skhansazoo/brick-pcbs/Brick05-VoltageSource03/ADP7118-regulator.kicad_sch

## KiCad design Brick05-VoltageSource03/ADP7118-regulator.kicad_sch (2025-06-24)

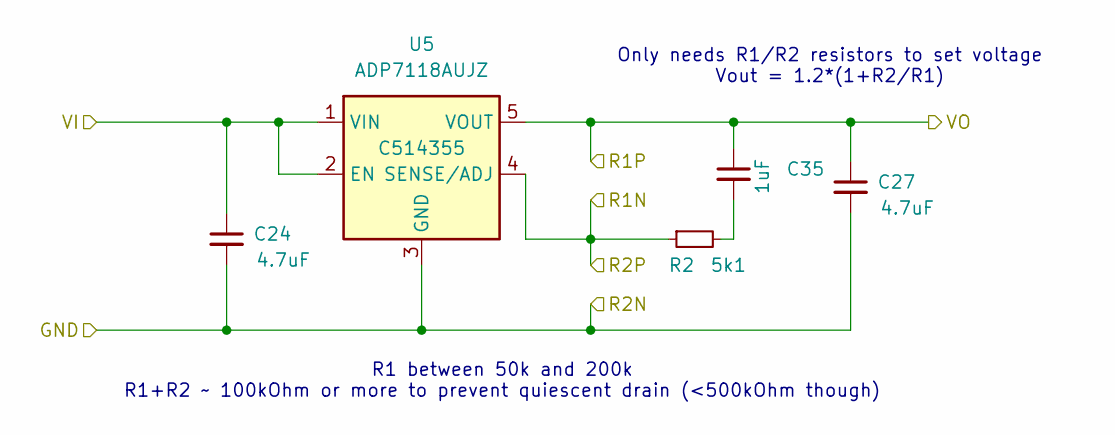
[picture p1: schematic ADP7118-regulator.kicad_sch]

Parts:
C24, C27: 4.7uF; C_0805_2012Metric; LCSC C1779
C35: 1uF; C_0603_1608Metric; LCSC C15849
R2: 5k1; R_0402_1005Metric; LCSC C25905
U5: ADP7118AUJZ; TSOT-23-5; LCSC C514355

Connections:
GND: C24.2, C27.2, U5.3 (GND)
unnamed: C35.2, R2.2
R1N: R2.1, U5.4 (SENSE/ADJ)
R1P: C27.1, C35.1, U5.5 (VOUT)
VI: C24.1, U5.1 (VIN), U5.2 (EN)

Notes on the sheet:
R1 between 50k and 200k R1+R2 ~ 100kOhm or more to prevent quiescent drain (<500kOhm though)
Only needs R1/R2 resistors to set voltage Vout = 1.2*(1+R2/R1)
