skhansazoo/brick-pcbs/Brick05-VoltageSource03/Brick05-VoltageSource03.kicad_sch

## KiCad design Brick05-VoltageSource03/Brick05-VoltageSource03.kicad_sch (2025-06-24)

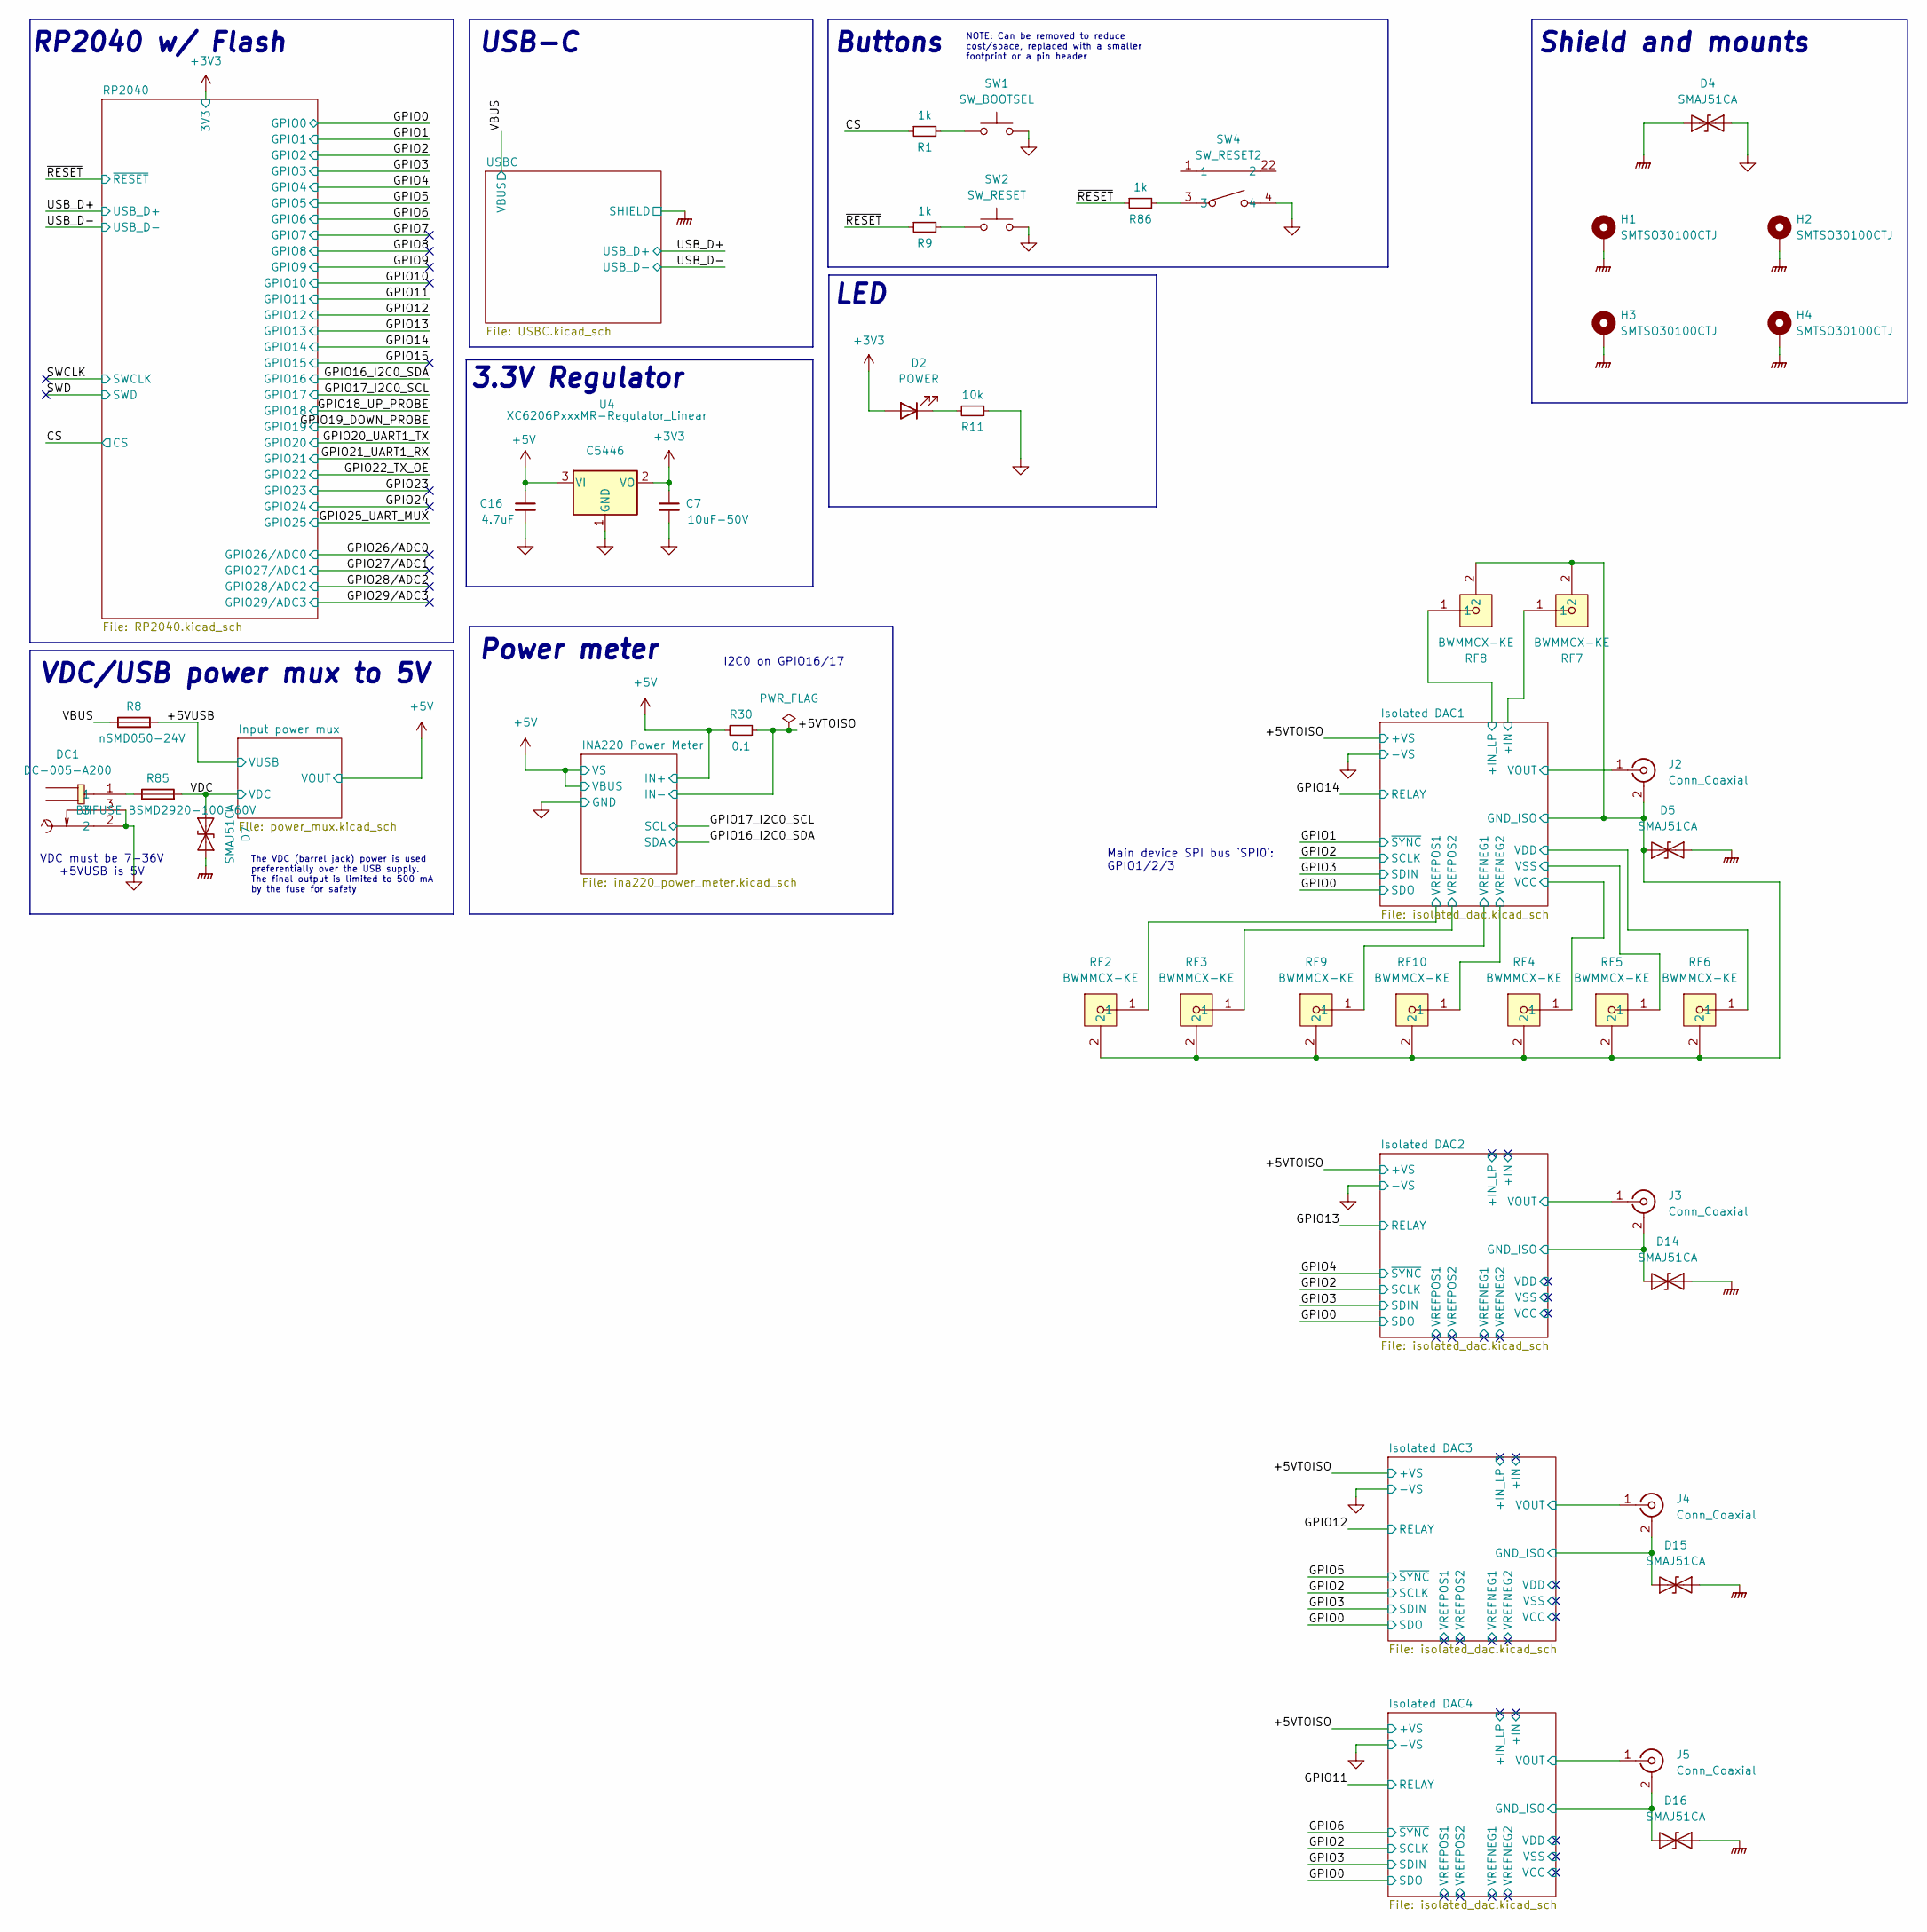
[picture p2: schematic Brick05-VoltageSource03.kicad_sch]

Parts:
C7: 10uF-50V; C_0805_2012Metric; LCSC C440198
C16: 4.7uF; C_0805_2012Metric; LCSC C1779
D2: POWER; LED_0805_2012Metric; LCSC C2297
D4, D5, D7, D14, D15, D16: SMAJ51CA; D_SMA; LCSC C148234
DC1: DC-005-A200; DC-IN-TH_DC-005-A200; LCSC Part C720557
H1, H2, H3, H4: SMTSO30100CTJ; SMD_BD5.6-L5.6-W5.6-D4.1; LCSC C2916370
J2, J3, J4, J5: Conn_Coaxial; BNC_Amphenol_B6252HB-NPP3G-50_Horizontal; LCSC C2837587
R1, R9, R86: 1k; R_0402_1005Metric; LCSC C11702
R8: nSMD050-24V; R_1206_3216Metric; LCSC C369160
R11: 10k; R_0402_1005Metric; LCSC C25744
R30: 0.1; R_1206_3216Metric; LCSC C25334
R85: BHFUSE BSMD2920-100-60V; Fuse_2920_7451Metric; LCSC C3020148
RF2, RF3, RF4, RF5, RF6, RF7, RF8, RF9, RF10: BWMMCX-KE; MMCX_Molex_73415-1471_Vertical; LCSC Part C5137198
SW1: SW_BOOTSEL; SW-SMD_L3.9-W3.0-P4.45; LCSC C720477
SW2: SW_RESET; SW-SMD_L3.9-W3.0-P4.45; LCSC C720477
SW4: SW_RESET2; SW-SMD_TS24CA; LCSC Part C393942
U4: XC6206PxxxMR-Regulator_Linear; SOT-23-3; LCSC C5446

Connections:
+3V3: C7.1, D2.2 (A), U4.2 (VO)
+5V: C16.1, R30.2, U4.3 (VI)
+5VTOISO: R30.1
+5VUSB: R8.2
+IN: RF7.1
+IN_LP: RF8.1
CS: R1.1
GND: C7.2, C16.2, D4.2 (A2), DC1.2, DC1.3, R11.2, SW1.1, SW2.1, SW4.4, U4.1 (GND)
GND_ISO: D5.1 (A1), D14.1 (A1), D15.1 (A1), D16.1 (A1), J2.2 (Ext), J3.2 (Ext), J4.2 (Ext), J5.2 (Ext), RF2.2, RF3.2, RF4.2, RF5.2, RF6.2, RF7.2, RF8.2, RF9.2, RF10.2
unnamed: D2.1 (K), R11.1
unnamed: DC1.1, R85.1
unnamed: R1.2, SW1.2
unnamed: R9.2, SW2.2
unnamed: R86.2, SW4.3
SHIELD: D4.1 (A1), D5.2 (A2), D7.2 (A2), D14.2 (A2), D15.2 (A2), D16.2 (A2), H1.1, H2.1, H3.1, H4.1
VBUS: R8.1
VCC: RF4.1
VDC: D7.1 (A1), R85.2
VDD: RF6.1
VOUT: J2.1 (In), J3.1 (In), J4.1 (In), J5.1 (In)
VREFNEG1: RF9.1
VREFNEG2: RF10.1
VREFPOS1: RF2.1
VREFPOS2: RF3.1
VSS: RF5.1
~RESET: R9.1, R86.1

Notes on the sheet:
RP2040 w/ Flash
3.3V Regulator
Shield and mounts
LED
VDC/USB power mux to 5V
USB-C
VDC must be 7-36V +5VUSB is 5V
Buttons
Power meter
The VDC (barrel jack) power is used preferentially over the USB supply. The final output is limited to 500 mA by the fuse for safety
Main device SPI bus `SPI0`: GPIO1/2/3
I2C0 on GPIO16/17
NOTE: Can be removed to reduce cost/space, replaced with a smaller footprint or a pin header
