skhansazoo/brick-pcbs/Brick05-VoltageSource03/RP2040.kicad_sch

## KiCad design Brick05-VoltageSource03/RP2040.kicad_sch (2025-06-24)

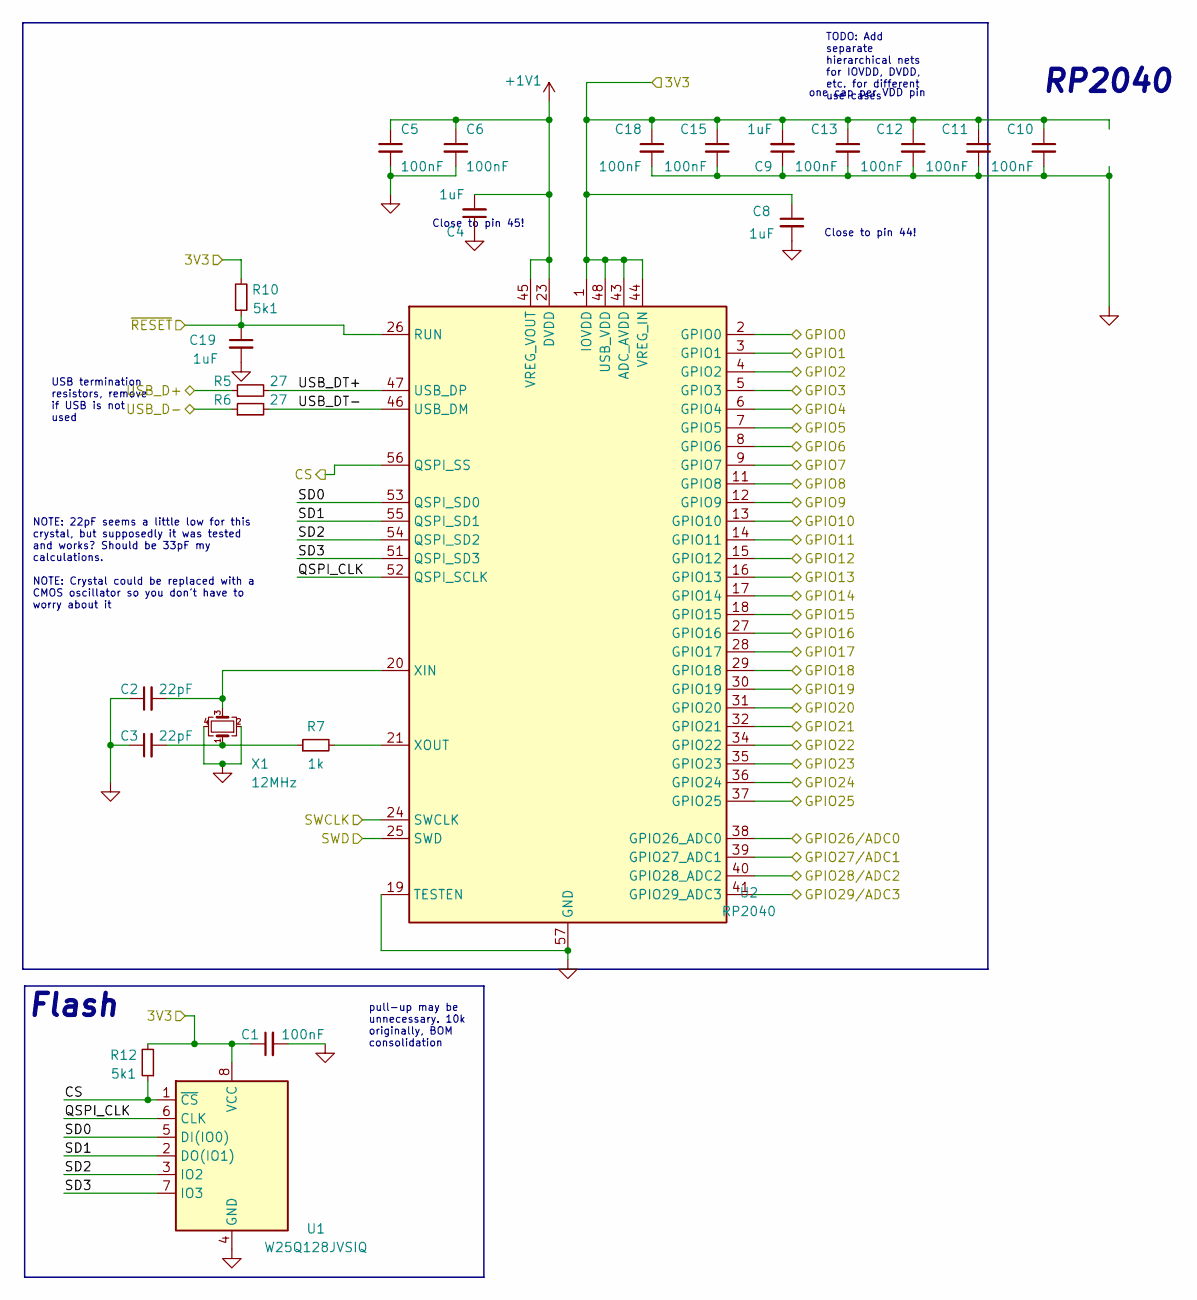
[picture p3: schematic RP2040.kicad_sch]

Parts:
C1, C5, C6, C10, C11, C12, C13, C15, C18: 100nF; C_0402_1005Metric; LCSC C1525
C2, C3: 22pF; C_0402_1005Metric; LCSC C1555
C4, C8, C9, C19: 1uF; C_0402_1005Metric; LCSC C52923
R5, R6: 27; R_0402_1005Metric; LCSC C138021
R7: 1k; R_0402_1005Metric; LCSC C11702
R10, R12: 5k1; R_0402_1005Metric; LCSC C25905
U1: W25Q128JVSIQ; SOIC-8_5.23x5.23mm_P1.27mm; LCSC C97521
U2: RP2040; QFN-56-1EP_7x7mm_P0.4mm_EP3.2x3.2mm; LCSC C2040
X1: 12MHz; Crystal_SMD_3225-4Pin_3.2x2.5mm; LCSC C9002

Connections:
3V3: C1.1, C8.1, C9.2, C10.1, C11.1, C12.1, C13.1, C15.1, C18.1, R10.2, R12.2, U1.8 (VCC), U2.1 (IOVDD), U2.10 (IOVDD), U2.22 (IOVDD), U2.33 (IOVDD), U2.42 (IOVDD), U2.43 (ADC_AVDD), U2.44 (VREG_IN), U2.48 (USB_VDD), U2.49 (IOVDD)
+1V1: C4.2, C5.1, C6.1, U2.23 (DVDD), U2.45 (VREG_VOUT), U2.50 (DVDD)
CS: R12.1, U1.1 (~CS), U2.56 (QSPI_SS)
GND: C1.2, C2.1, C3.1, C4.1, C5.2, C6.2, C8.2, C9.1, C10.2, C11.2, C12.2, C13.2, C15.2, C18.2, C19.2, U1.4 (GND), U2.19 (TESTEN), U2.57 (GND), X1.2, X1.4
GPIO0: U2.2 (GPIO0)
GPIO1: U2.3 (GPIO1)
GPIO2: U2.4 (GPIO2)
GPIO3: U2.5 (GPIO3)
GPIO4: U2.6 (GPIO4)
GPIO5: U2.7 (GPIO5)
GPIO6: U2.8 (GPIO6)
GPIO7: U2.9 (GPIO7)
GPIO8: U2.11 (GPIO8)
GPIO9: U2.12 (GPIO9)
GPIO10: U2.13 (GPIO10)
GPIO11: U2.14 (GPIO11)
GPIO12: U2.15 (GPIO12)
GPIO13: U2.16 (GPIO13)
GPIO14: U2.17 (GPIO14)
GPIO15: U2.18 (GPIO15)
GPIO16: U2.27 (GPIO16)
GPIO17: U2.28 (GPIO17)
GPIO18: U2.29 (GPIO18)
GPIO19: U2.30 (GPIO19)
GPIO20: U2.31 (GPIO20)
GPIO21: U2.32 (GPIO21)
GPIO22: U2.34 (GPIO22)
GPIO23: U2.35 (GPIO23)
GPIO24: U2.36 (GPIO24)
GPIO25: U2.37 (GPIO25)
GPIO26/ADC0: U2.38 (GPIO26_ADC0)
GPIO27/ADC1: U2.39 (GPIO27_ADC1)
GPIO28/ADC2: U2.40 (GPIO28_ADC2)
GPIO29/ADC3: U2.41 (GPIO29_ADC3)
unnamed: C2.2, U2.20 (XIN), X1.3
unnamed: C3.2, R7.1, X1.1
unnamed: R7.2, U2.21 (XOUT)
QSPI_CLK: U1.6 (CLK), U2.52 (QSPI_SCLK)
SD0: U1.5 (DI(IO0)), U2.53 (QSPI_SD0)
SD1: U1.2 (DO(IO1)), U2.55 (QSPI_SD1)
SD2: U1.3 (IO2), U2.54 (QSPI_SD2)
SD3: U1.7 (IO3), U2.51 (QSPI_SD3)
SWCLK: U2.24 (SWCLK)
SWD: U2.25 (SWD)
USB_D+: R5.1
USB_D-: R6.1
USB_DT+: R5.2, U2.47 (USB_DP)
USB_DT-: R6.2, U2.46 (USB_DM)
~RESET: C19.1, R10.1, U2.26 (RUN)

Notes on the sheet:
RP2040
Flash
USB termination resistors, remove if USB is not used
Close to pin 45!
one cap per VDD pin
NOTE: 22pF seems a little low for this crystal, but supposedly it was tested and works? Should be 33pF my calculations. NOTE: Crystal could be replaced with a CMOS oscillator so you don't have to worry about it
TODO: Add separate hierarchical nets for IOVDD, DVDD, etc. for different use cases
pull-up may be unnecessary. 10k originally, BOM consolidation
Close to pin 44!
