skhansazoo/brick-pcbs/Brick05-VoltageSource03/USBC.kicad_sch

## KiCad design Brick05-VoltageSource03/USBC.kicad_sch (2025-06-24)

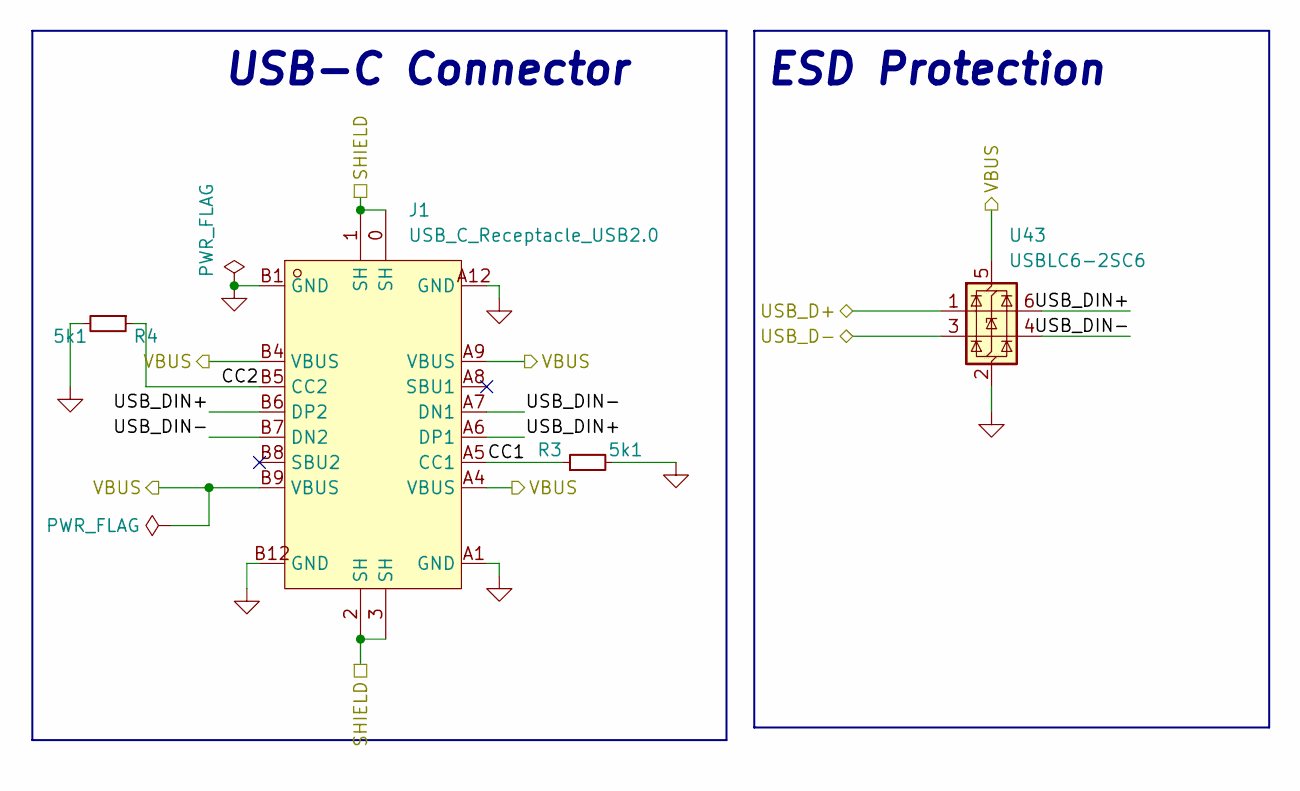
[picture p4: schematic USBC.kicad_sch]

Parts:
J1: USB_C_Receptacle_USB2.0; USB-C_SMD-TYPE-C-31-M-12; LCSC C165948
R3, R4: 5k1; R_0402_1005Metric; LCSC C25905
U43: USBLC6-2SC6; SOT-23-6; LCSC C2827654

Connections:
CC1: J1.A5 (CC1), R3.1
CC2: J1.B5 (CC2), R4.1
GND: J1.A1 (GND), J1.A12 (GND), J1.B1 (GND), J1.B12 (GND), R3.2, R4.2, U43.2 (GND)
SHIELD: J1.0 (SH), J1.1 (SH), J1.2 (SH), J1.3 (SH)
USB_D+: U43.1 (I/O1)
USB_D-: U43.3 (I/O2)
USB_DIN+: J1.A6 (DP1), J1.B6 (DP2), U43.6 (I/O1)
USB_DIN-: J1.A7 (DN1), J1.B7 (DN2), U43.4 (I/O2)
VBUS: J1.A4 (VBUS), J1.A9 (VBUS), J1.B4 (VBUS), J1.B9 (VBUS), U43.5 (VBUS)

Notes on the sheet:
USB-C Connector
ESD Protection
