skhansazoo/brick-pcbs/Brick05-VoltageSource03/ad5781.kicad_sch

## KiCad design Brick05-VoltageSource03/ad5781.kicad_sch (2025-06-24)

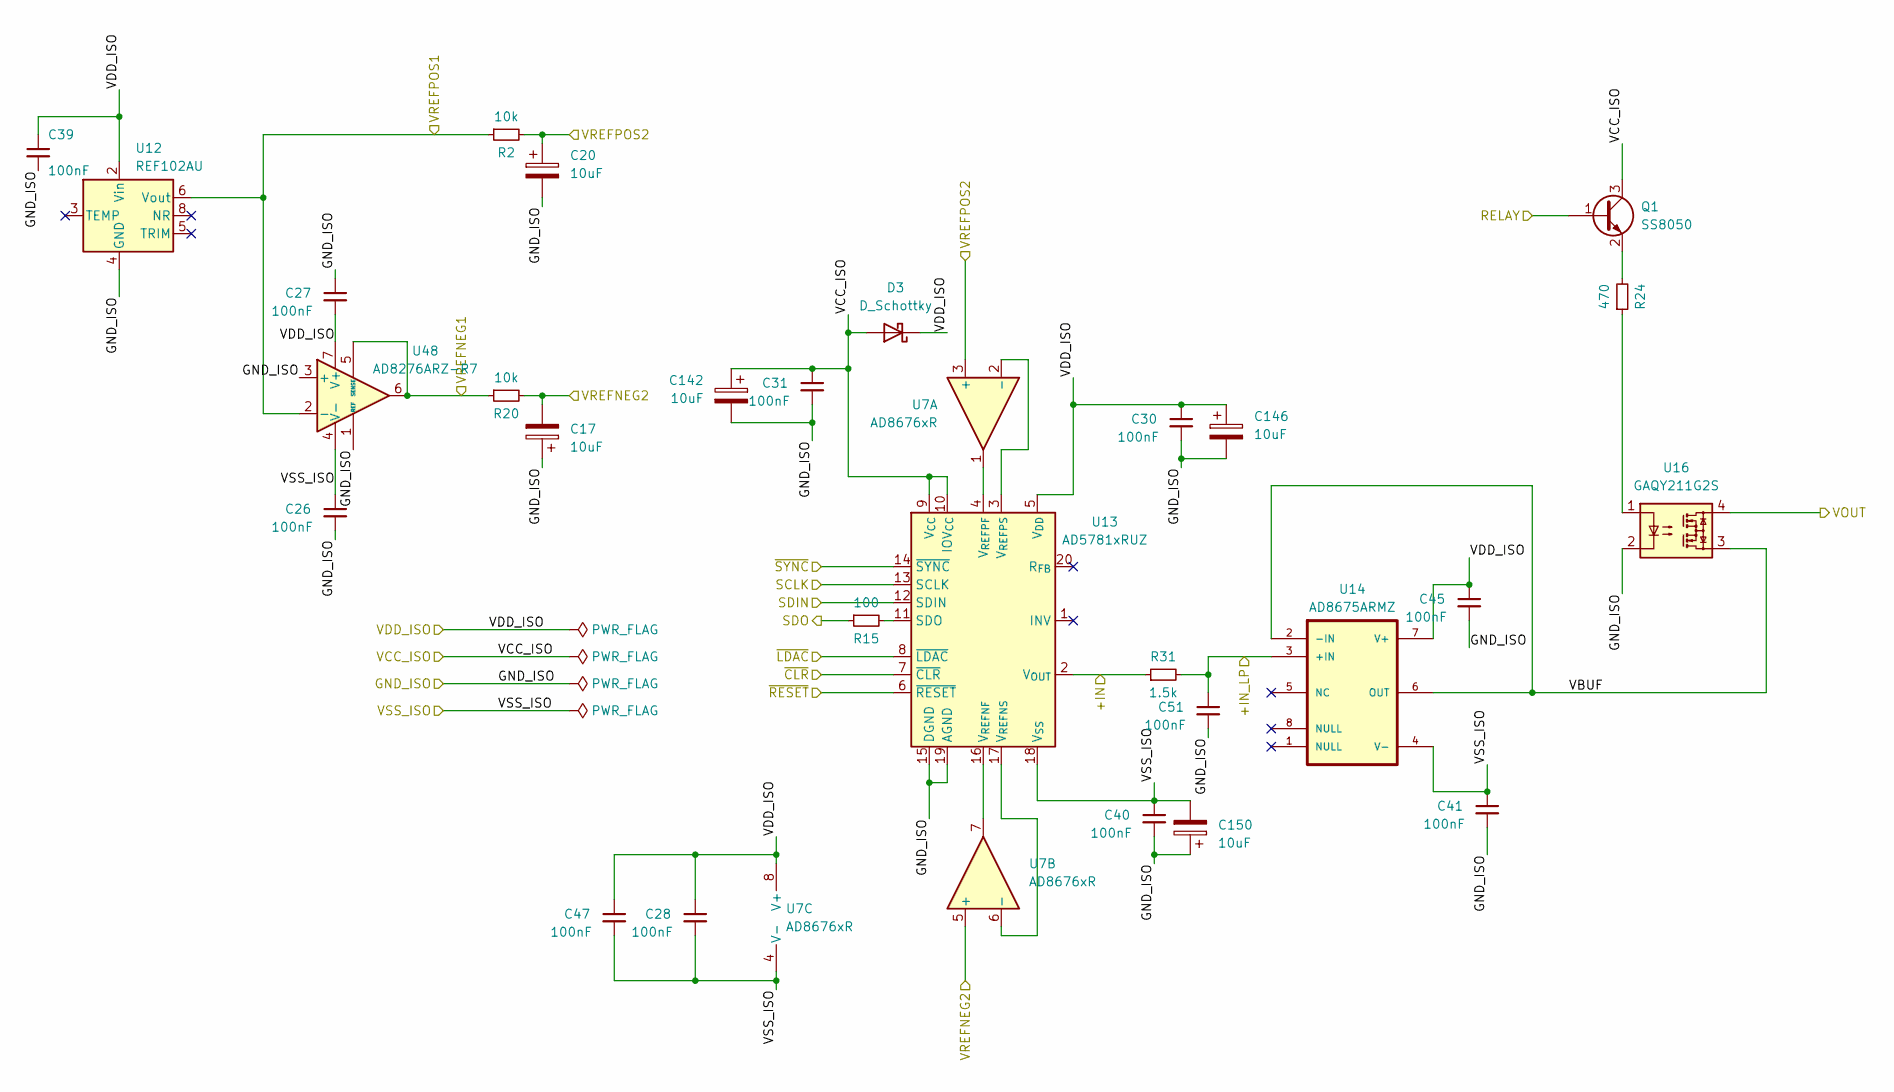
[picture p5: schematic ad5781.kicad_sch]

Parts:
C17, C20, C142, C146, C150: 10uF; CP_EIA-3216-18_Kemet-A; LCSC C7171
C26, C27, C28, C30, C31, C40, C41, C45, C47, C51: 100nF; C_1206_3216Metric; LCSC C170182
C39: 100nF; C_0402_1005Metric; LCSC C1525
D3: D_Schottky; D_SOD-323; LCSC C191023
Q1: SS8050; SOT-23; LCSC C2150
R2, R20: 10k; R_0402_1005Metric; LCSC C25744
R15: 100; R_0402_1005Metric; LCSC C25076
R24: 470; R_0402_1005Metric; LCSC C25117
R31: 1.5k; R_0402_1005Metric; LCSC C25867
U7: AD8676xR; SOIC-8_3.9x4.9mm_P1.27mm; LCSC C462199
U12: REF102AU; SOIC-8_3.9x4.9mm_P1.27mm; LCSC C183082
U13: AD5781xRUZ; TSSOP-20_4.4x6.5mm_P0.65mm; LCSC C650269
U14: AD8675ARMZ; MSOP-8_3x3mm_P0.65mm; LCSC C208295
U16: GAQY211G2S; SO-4_4.4x3.9mm_P2.54mm; LCSC C7435104
U48: AD8276ARZ-R7; SOIC-8_3.9x4.9mm_P1.27mm; LCSC C514259

Connections:
+IN: R31.1, U13.2 (V_{OUT})
+IN_LP: C51.1, R31.2, U14.3 (+IN)
GND_ISO: C17.1, C20.2, C26.2, C27.1, C30.2, C31.2, C39.2, C40.2, C41.2, C45.2, C51.2, C142.2, C146.2, C150.1, U12.4 (GND), U13.15 (DGND), U13.19 (AGND), U16.2, U48.1 (REF), U48.3 (+)
unnamed: Q1.2 (E), R24.2
unnamed: R15.2, U13.11 (SDO)
unnamed: R24.1, U16.1
unnamed: U7.2 (-), U13.3 (V_{REFPS})
unnamed: U7.1, U13.4 (V_{REFPF})
unnamed: U7.7, U13.16 (V_{REFNF})
unnamed: U7.6 (-), U13.17 (V_{REFNS})
RELAY: Q1.1 (B)
SCLK: U13.13 (SCLK)
SDIN: U13.12 (SDIN)
SDO: R15.1
VBUF: U14.2 (-IN), U14.6 (OUT), U16.3
VCC_ISO: C31.1, C142.1, D3.2 (A), Q1.3 (C), U13.9 (V_{CC}), U13.10 (IOV_{CC})
VDD_ISO: C27.2, C28.1, C30.1, C39.1, C45.1, C47.1, C146.1, D3.1 (K), U7.8 (V+), U12.2 (Vin), U13.5 (V_{DD}), U14.7 (V+), U48.7 (V+)
VOUT: U16.4
VREFNEG1: R20.1, U48.5 (SENSE), U48.6
VREFNEG2: C17.2, R20.2, U7.5 (+)
VREFPOS1: R2.1, U12.6 (Vout), U48.2 (-)
VREFPOS2: C20.1, R2.2, U7.3 (+)
VSS_ISO: C26.1, C28.2, C40.1, C41.1, C47.2, C150.2, U7.4 (V-), U13.18 (V_{SS}), U14.4 (V-), U48.4 (V-)
~CLR: U13.7 (~CLR)
~LDAC: U13.8 (~LDAC)
~RESET: U13.6 (~RESET)
~SYNC: U13.14 (~SYNC)
