skhansazoo/brick-pcbs/Brick05-VoltageSource03/ina220_power_meter.kicad_sch

## KiCad design Brick05-VoltageSource03/ina220_power_meter.kicad_sch (2025-06-24)

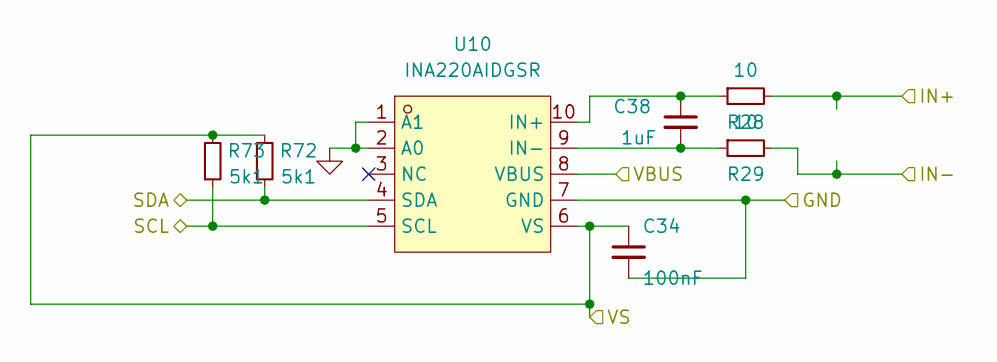
[picture p6: schematic ina220_power_meter.kicad_sch]

Parts:
C34: 100nF; C_0402_1005Metric; LCSC C1525
C38: 1uF; C_0402_1005Metric; LCSC C52923
R28, R29: 10; R_0402_1005Metric; LCSC C25077
R72, R73: 5k1; R_0402_1005Metric; LCSC C25905
U10: INA220AIDGSR; VSSOP-10_L3.0-W3.0-P0.50-LS4.9-BL; LCSC Part C543040

Connections:
GND: C34.2, U10.1 (A1), U10.2 (A0), U10.7 (GND)
IN+: R28.2
IN-: R29.2
unnamed: C38.1, R28.1, U10.10 (IN+)
unnamed: C38.2, R29.1, U10.9 (IN-)
SCL: R73.1, U10.5 (SCL)
SDA: R72.1, U10.4 (SDA)
VBUS: U10.8 (VBUS)
VS: C34.1, R72.2, R73.2, U10.6 (VS)
