skhansazoo/brick-pcbs/Brick05-VoltageSource03/isolated_dac.kicad_sch

## KiCad design Brick05-VoltageSource03/isolated_dac.kicad_sch (2025-06-24)

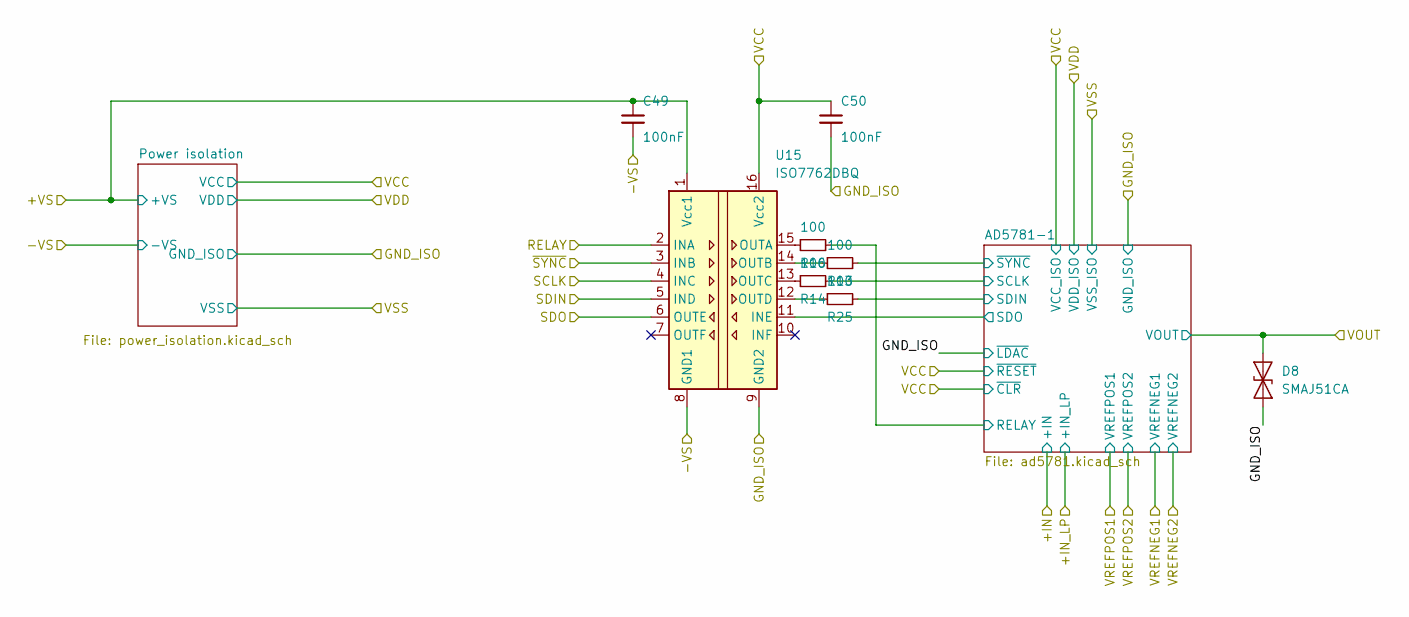
[picture p7: schematic isolated_dac.kicad_sch]

Parts:
C49, C50: 100nF; C_0402_1005Metric; LCSC C1525
D8: SMAJ51CA; D_SMA; LCSC C148234
R13, R14, R16, R25: 100; R_0402_1005Metric; LCSC C25076
U15: ISO7762DBQ; SSOP-16_3.9x4.9mm_P0.635mm; LCSC C2868090

Connections:
+VS: C49.1, U15.1 (Vcc1)
-VS: C49.2, U15.8 (GND1)
GND_ISO: C50.2, D8.1 (A1), U15.9 (GND2)
unnamed: R13.1, U15.14 (OUTB)
unnamed: R14.1, U15.13 (OUTC)
unnamed: R16.1, U15.15 (OUTA)
unnamed: R25.1, U15.12 (OUTD)
RELAY: R16.2, U15.2 (INA)
SCLK: R14.2, U15.4 (INC)
SDIN: R25.2, U15.5 (IND)
SDO: U15.6 (OUTE), U15.11 (INE)
VCC: C50.1, U15.16 (Vcc2)
VOUT: D8.2 (A2)
~SYNC: R13.2, U15.3 (INB)
