skhansazoo/brick-pcbs/Brick05-VoltageSource03/power_isolation.kicad_sch

## KiCad design Brick05-VoltageSource03/power_isolation.kicad_sch (2025-06-24)

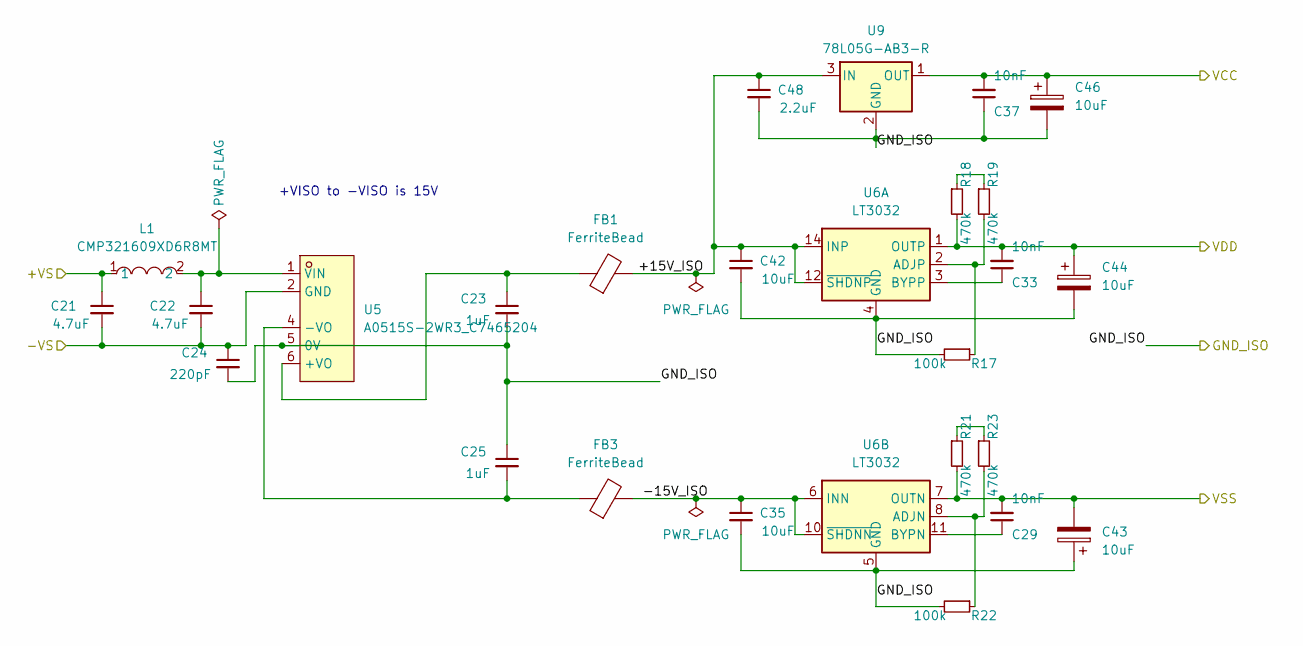
[picture p8: schematic power_isolation.kicad_sch]

Parts:
C21, C22: 4.7uF; C_0805_2012Metric; LCSC C1779
C23, C25: 1uF; C_0402_1005Metric; LCSC C52923
C24: 220pF; C_1206_3216Metric; LCSC C63848
C29, C33, C37: 10nF; C_0402_1005Metric; LCSC C1518210
C35, C42: 10uF; C_0805_2012Metric; LCSC C440198
C43, C44, C46: 10uF; CP_EIA-3216-18_Kemet-A; LCSC C7171
C48: 2.2uF; C_0805_2012Metric; LCSC C377773
FB1, FB3: FerriteBead; L_0805_2012Metric; LCSC C1017
L1: CMP321609XD6R8MT; L_1206_3216Metric; LCSC Part C395031
R17, R22: 100k; R_0402_1005Metric; LCSC C25741
R18, R19, R21, R23: 470k; R_0402_1005Metric; LCSC C25790
U5: A0515S-2WR3_C7465204; PWRM-TH_AXXXXS-2WR3; LCSC Part C7465204
U6: LT3032; Linear_DE14MA; LCSC C666532
U9: 78L05G-AB3-R; SOT-89-3; LCSC C71136

Connections:
+15V_ISO: C42.1, C48.1, FB1.2, U6.12 (~SHDNP), U6.14 (INP), U9.3 (IN)
+VS: C21.1, L1.1
-15V_ISO: C35.1, FB3.2, U6.6 (INN), U6.9 (INN), U6.10 (~SHDNN)
-VS: C21.2, C22.2, C24.1, U5.2 (GND)
GND_ISO: C23.2, C24.2, C25.1, C35.2, C37.1, C42.2, C43.1, C44.2, C46.2, C48.2, R17.2, R22.2, U5.5 (0V), U6.4 (GND), U6.5 (GND), U9.2 (GND)
unnamed: C22.1, L1.2, U5.1 (VIN)
unnamed: C23.1, FB1.1, U5.6 (+VO)
unnamed: C25.2, FB3.1, U5.4 (-VO)
unnamed: C29.1, U6.11 (BYPN)
unnamed: C33.1, U6.3 (BYPP)
unnamed: R17.1, R19.2, U6.2 (ADJP)
unnamed: R18.1, R19.1
unnamed: R21.1, R23.1
unnamed: R22.1, R23.2, U6.8 (ADJN)
VCC: C37.2, C46.1, U9.1 (OUT)
VDD: C33.2, C44.1, R18.2, U6.1 (OUTP)
VSS: C29.2, C43.2, R21.2, U6.7 (OUTN)

Notes on the sheet:
+VISO to -VISO is 15V
