skhansazoo/brick-pcbs/Brick05-VoltageSource03/power_mux.kicad_sch

## KiCad design Brick05-VoltageSource03/power_mux.kicad_sch (2025-06-24)

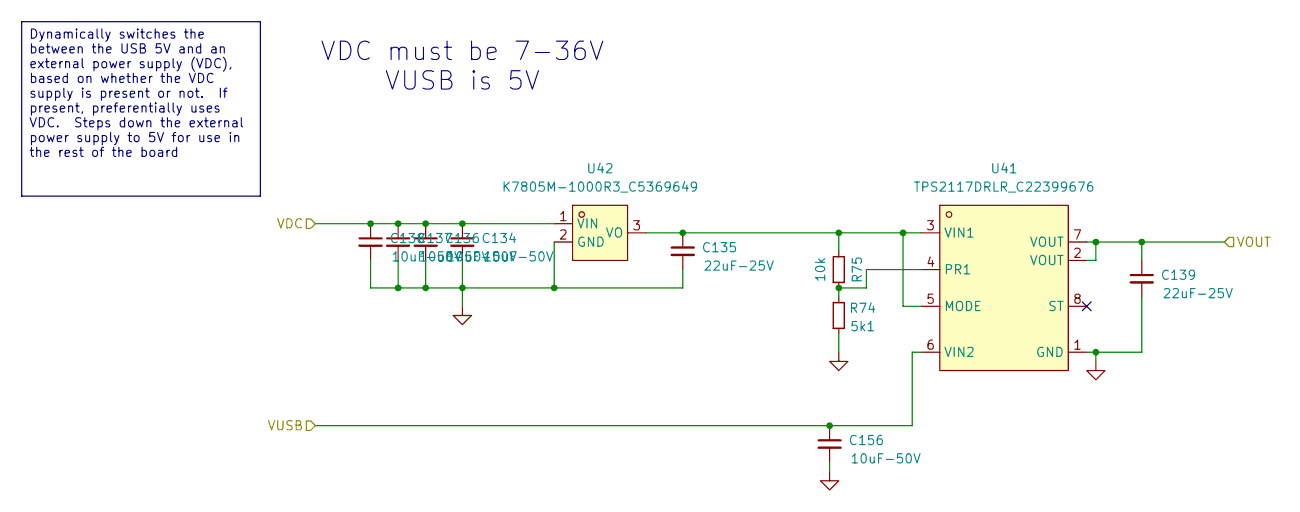
[picture p9: schematic power_mux.kicad_sch]

Parts:
C134, C136, C137, C138, C156: 10uF-50V; C_0805_2012Metric; LCSC C440198
C135, C139: 22uF-25V; C_0805_2012Metric; LCSC C45783
R74: 5k1; R_0402_1005Metric; LCSC C25905
R75: 10k; R_0402_1005Metric; LCSC C25744
U41: TPS2117DRLR_C22399676; SOT-583-8_L2.1-W1.2-P0.50-LS1.6-BL; LCSC Part C22399676
U42: K7805M-1000R3_C5369649; PWRM-TH_DEXU_K780XM-1000R3; LCSC Part C5369649

Connections:
GND: C134.2, C135.2, C136.2, C137.2, C138.2, C139.2, C156.2, R74.1, U41.1 (GND), U42.2 (GND)
unnamed: C135.1, R75.2, U41.3 (VIN1), U41.5 (MODE), U42.3 (VO)
unnamed: R74.2, R75.1, U41.4 (PR1)
VDC: C134.1, C136.1, C137.1, C138.1, U42.1 (VIN)
VOUT: C139.1, U41.2 (VOUT), U41.7 (VOUT)
VUSB: C156.1, U41.6 (VIN2)

Notes on the sheet:
VDC must be 7-36V VUSB is 5V
Dynamically switches the between the USB 5V and an external power supply (VDC), based on whether the VDC supply is present or not. If present, preferentially uses VDC. Steps down the external power supply to 5V for use in the rest of the board
